bitbangbill/photoelectric-effect-demonstrator/pcb/3d/USB4110-GF-A.STEP

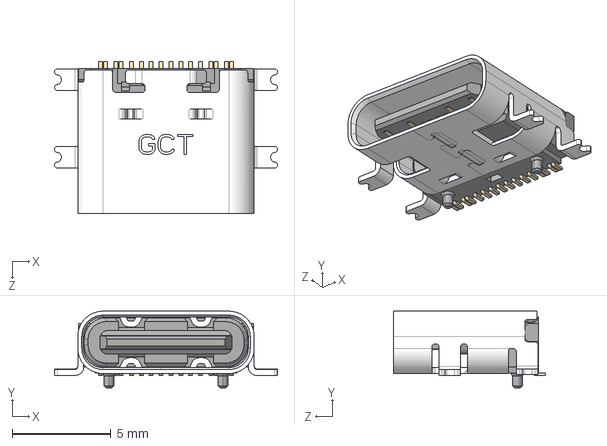
[picture p1: CAD file, 2026-09-15]
pcb/3d/USB4110-GF-A.STEP
11.3 x 3.89 x 7.70 mm
