bitbangbill/photoelectric-effect-demonstrator/pcb/3d/CCG6-12-15DR.step

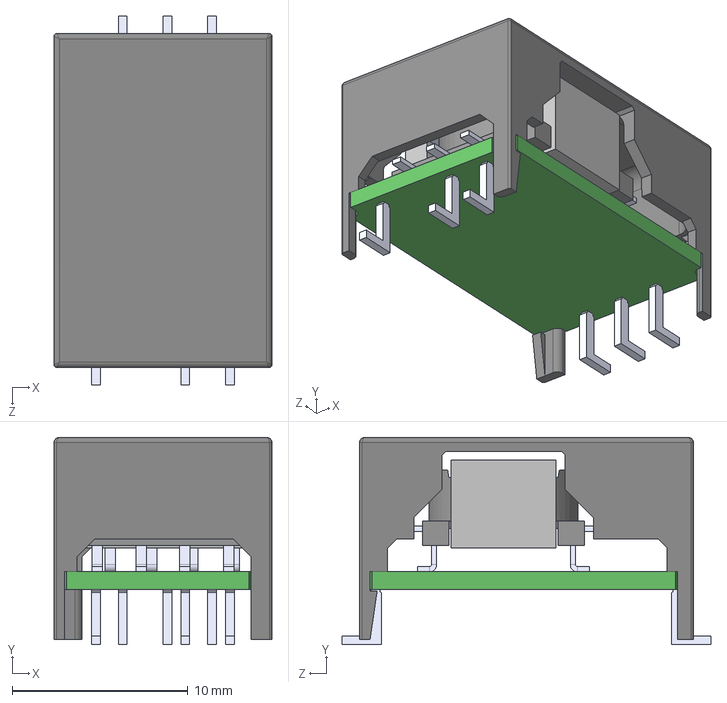
[picture p2: CAD file, 2026-09-15]
pcb/3d/CCG6-12-15DR.step
12.4 x 11.8 x 21.0 mm
