bitbangbill/photoelectric-effect-demonstrator/pcb/3d/USB4135-GF-A.step

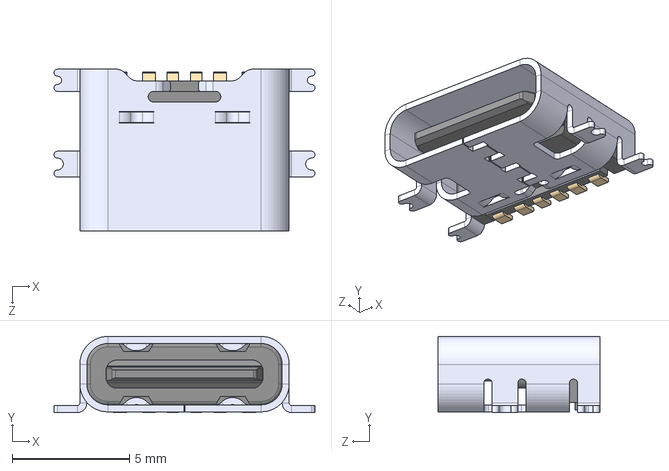
[picture p3: CAD file, 2026-09-15]
pcb/3d/USB4135-GF-A.step
11.1 x 3.25 x 6.90 mm
