bitbangbill/photoelectric-effect-demonstrator/pcb/3d/srf0905.stp

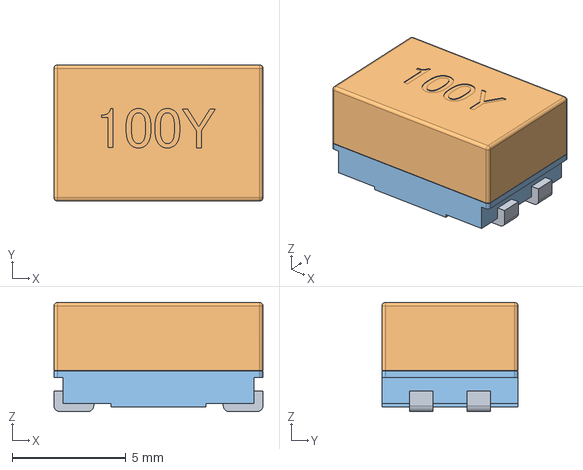
[picture p4: CAD file, 2026-09-15]
pcb/3d/srf0905.stp
9.20 x 6.00 x 4.80 mm
