bitbangbill/photoelectric-effect-demonstrator/pcb/3d/TLV75533PDBVR.STEP

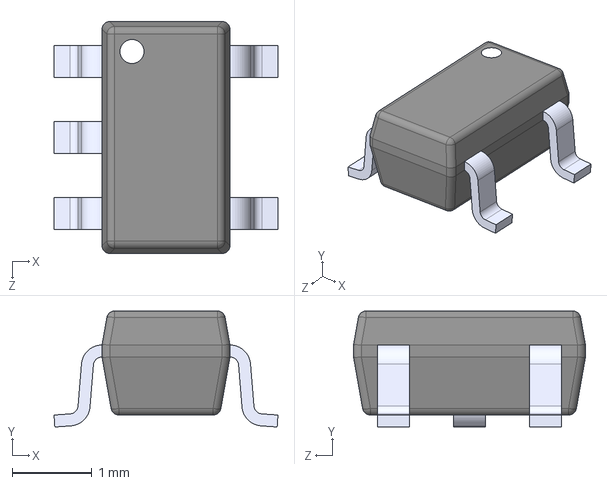
[picture p5: CAD file, 2026-09-15]
pcb/3d/TLV75533PDBVR.STEP
2.80 x 1.45 x 2.90 mm
