bitbangbill/photoelectric-effect-demonstrator/pcb/adc.kicad_sch

## KiCad design pcb/adc.kicad_sch (2026-09-15)

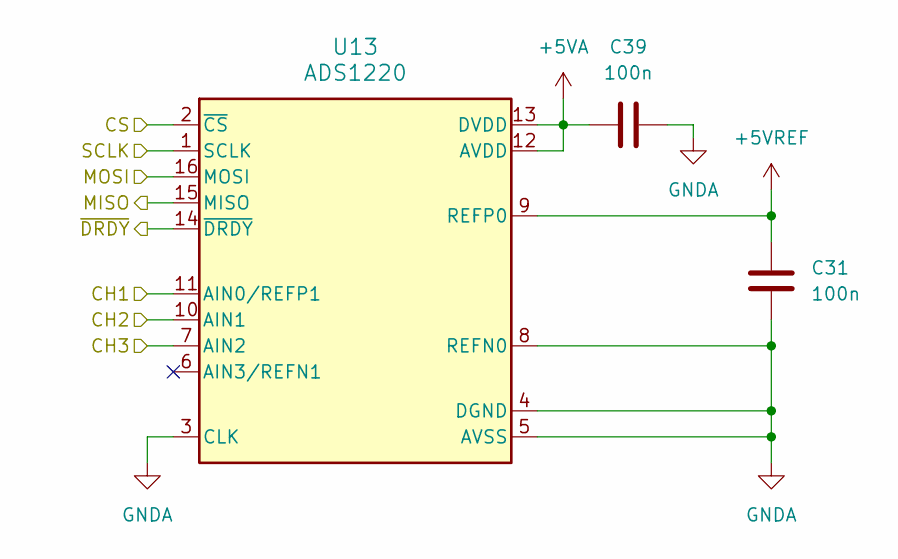
[picture p6: schematic adc.kicad_sch]

Parts:
C31, C39: 100n; C_0603_1608Metric
U13: ADS1220; TSSOP-16_4.4x5mm_P0.65mm

Connections:
+5VA: C39.1, U13.12 (AVDD), U13.13 (DVDD)
+5VREF: C31.1, U13.9 (REFP0)
CH1: U13.11 (AIN0/REFP1)
CH2: U13.10 (AIN1)
CH3: U13.7 (AIN2)
CS: U13.2 (~CS)
GNDA: C31.2, C39.2, U13.3 (CLK), U13.4 (DGND), U13.5 (AVSS), U13.8 (REFN0)
MISO: U13.15 (MISO)
MOSI: U13.16 (MOSI)
SCLK: U13.1 (SCLK)
~DRDY: U13.14 (~DRDY)
