bitbangbill/photoelectric-effect-demonstrator/pcb/digital_isolation.kicad_sch

## KiCad design pcb/digital_isolation.kicad_sch (2026-09-15)

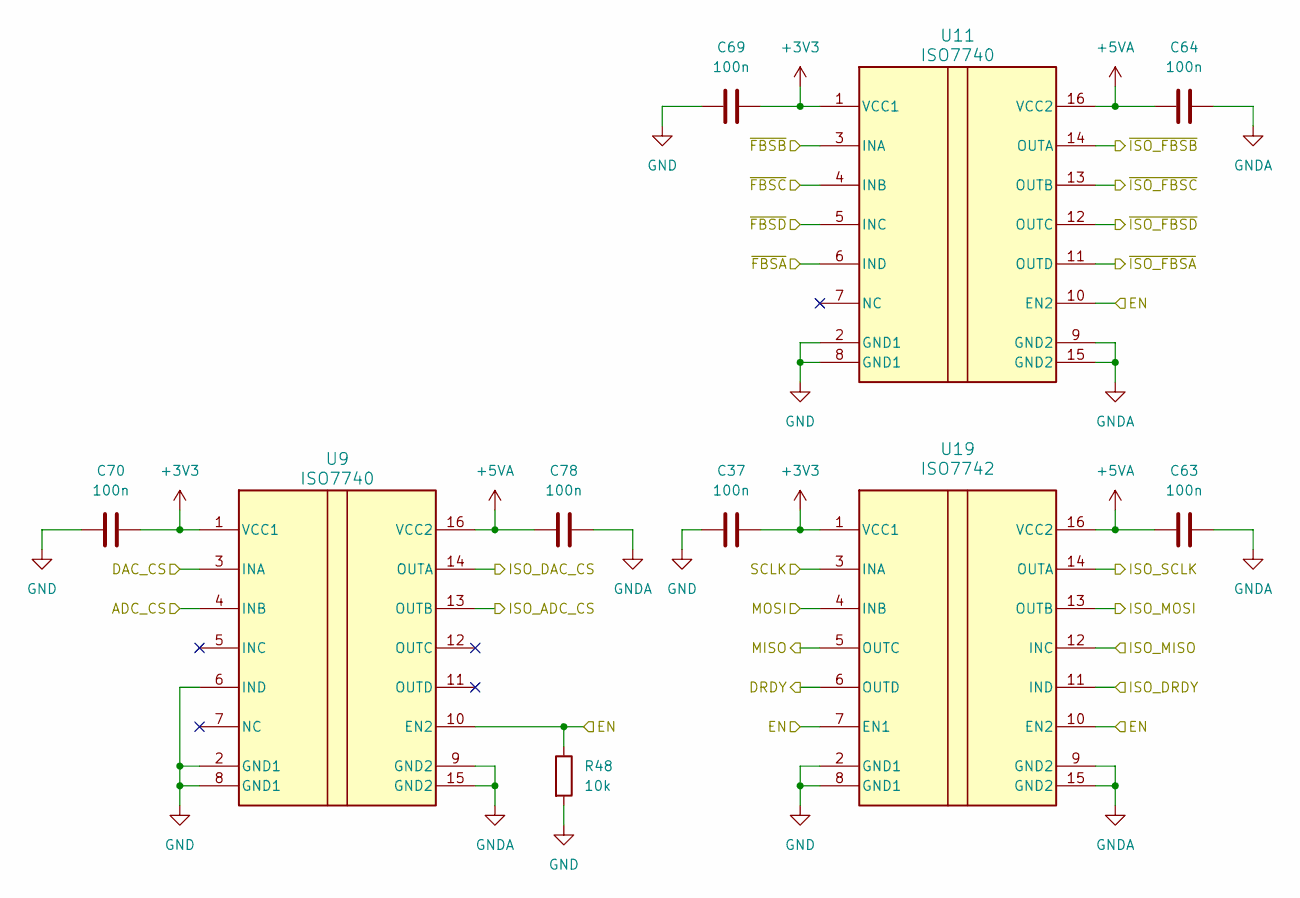
[picture p7: schematic digital_isolation.kicad_sch]

Parts:
C37, C63, C64, C69, C70, C78: 100n; C_0603_1608Metric
R48: 10k; R_0603_1608Metric
U9, U11: ISO7740; SSOP-16_3.9x4.9mm_P0.635mm
U19: ISO7742; SSOP-16_3.9x4.9mm_P0.635mm

Connections:
+3V3: C37.2, C69.2, C70.2, U9.1 (VCC1), U11.1 (VCC1), U19.1 (VCC1)
+5VA: C63.1, C64.1, C78.1, U9.16 (VCC2), U11.16 (VCC2), U19.16 (VCC2)
ADC_CS: U9.4 (INB)
DAC_CS: U9.3 (INA)
DRDY: U19.6 (OUTD)
EN: R48.1, U9.10 (EN2), U11.10 (EN2), U19.7 (EN1), U19.10 (EN2)
GND: C37.1, C69.1, C70.1, R48.2, U9.2 (GND1), U9.6 (IND), U9.8 (GND1), U11.2 (GND1), U11.8 (GND1), U19.2 (GND1), U19.8 (GND1)
GNDA: C63.2, C64.2, C78.2, U9.9 (GND2), U9.15 (GND2), U11.9 (GND2), U11.15 (GND2), U19.9 (GND2), U19.15 (GND2)
ISO_ADC_CS: U9.13 (OUTB)
ISO_DAC_CS: U9.14 (OUTA)
ISO_DRDY: U19.11 (IND)
ISO_MISO: U19.12 (INC)
ISO_MOSI: U19.13 (OUTB)
ISO_SCLK: U19.14 (OUTA)
MISO: U19.5 (OUTC)
MOSI: U19.4 (INB)
SCLK: U19.3 (INA)
~FBSA: U11.6 (IND)
~FBSB: U11.3 (INA)
~FBSC: U11.4 (INB)
~FBSD: U11.5 (INC)
~ISO_FBSA: U11.11 (OUTD)
~ISO_FBSB: U11.14 (OUTA)
~ISO_FBSC: U11.13 (OUTB)
~ISO_FBSD: U11.12 (OUTC)
