bitbangbill/photoelectric-effect-demonstrator/pcb/dual_rail_variable_psu.kicad_sch

## KiCad design pcb/dual_rail_variable_psu.kicad_sch (2026-09-15)

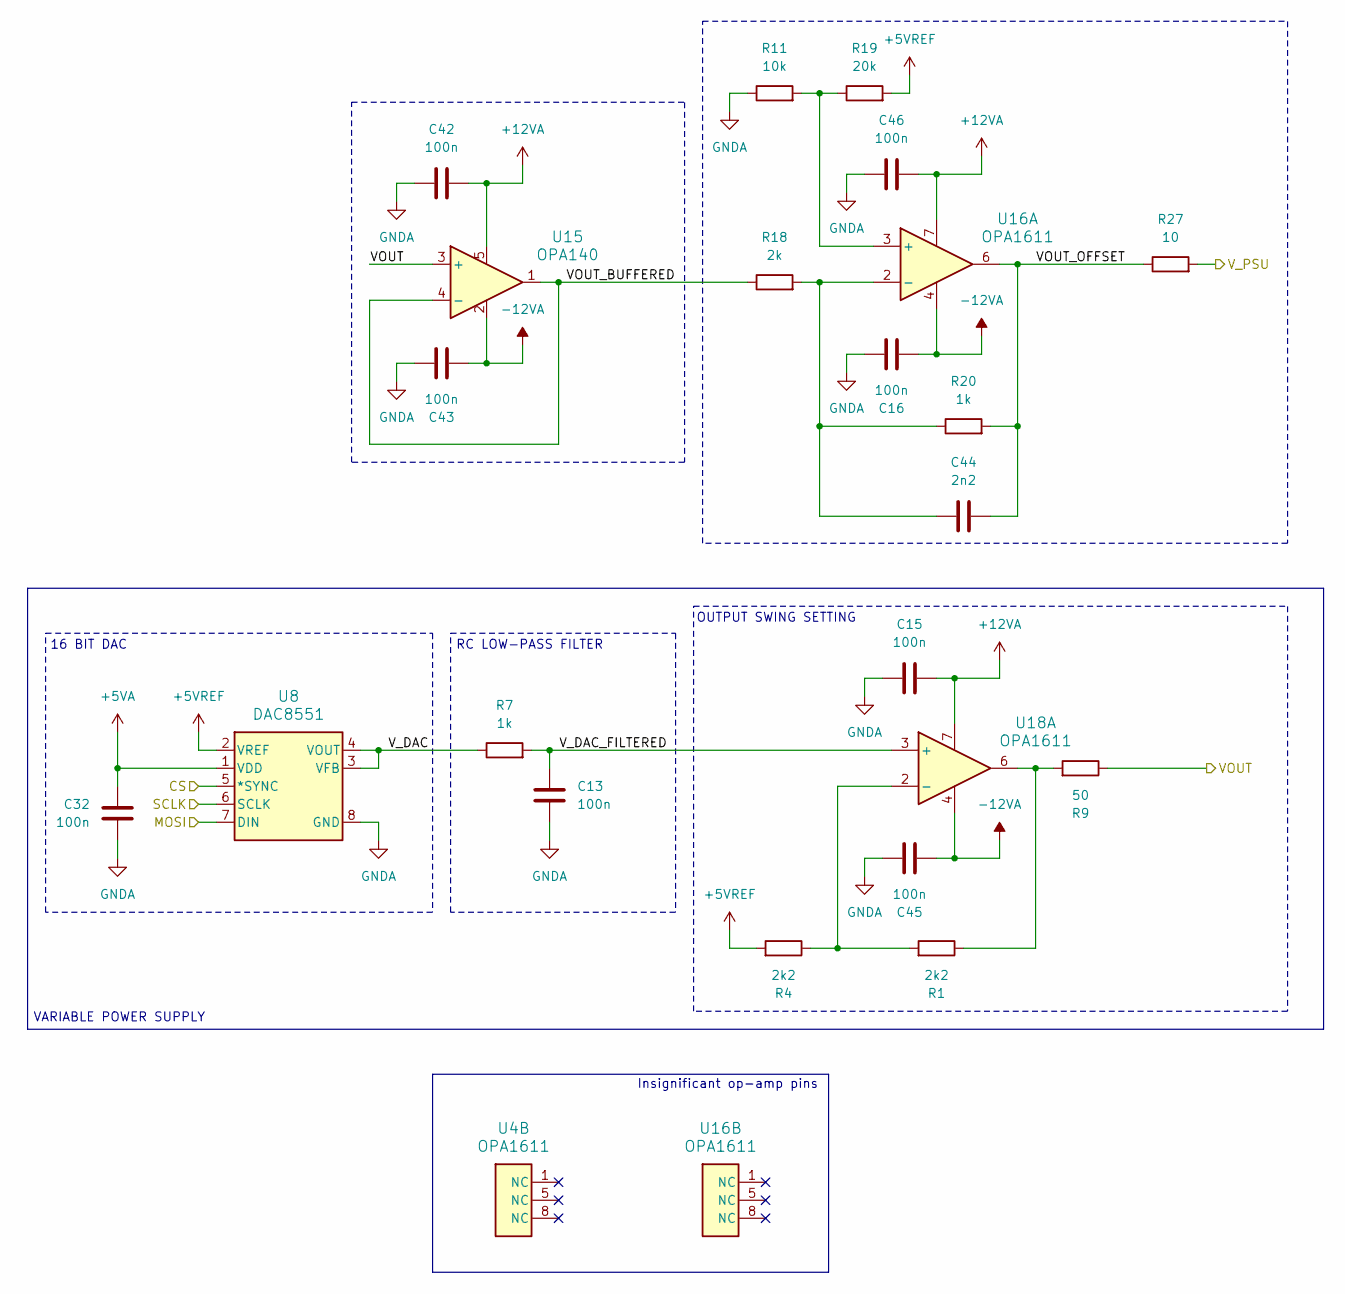
[picture p8: schematic dual_rail_variable_psu.kicad_sch]

Parts:
C13, C15, C16, C32, C42, C43, C45, C46: 100n; C_0603_1608Metric
C44: 2n2; C_0603_1608Metric
R1, R4: 2k2; R_0603_1608Metric
R7, R20: 1k; R_0603_1608Metric
R9: 50; R_0603_1608Metric
R11: 10k; R_0603_1608Metric
R18: 2k; R_0603_1608Metric
R19: 20k; R_0603_1608Metric
R27: 10; R_0603_1608Metric
U4, U16, U18: OPA1611; SOIC-8_3.9x4.9mm_P1.27mm
U8: DAC8551; VSSOP-8_3x3mm_P0.65mm
U15: OPA140; SOT-23-5

Connections:
+5VA: C32.1, U8.1 (VDD)
+5VREF: R4.2, R19.2, U8.2 (VREF)
+12VA: C15.2, C42.2, C46.2, U15.5, U16.7, U18.7
-12VA: C16.2, C43.2, C45.2, U15.2, U16.4, U18.4
CS: U8.5 (*SYNC)
GNDA: C13.2, C15.1, C16.1, C32.2, C42.1, C43.1, C45.1, C46.1, R11.1, U8.8 (GND)
MOSI: U8.7 (DIN)
unnamed: C44.1, R18.2, R20.1, U16.2 (-)
unnamed: R1.1, R9.2, U18.6
unnamed: R1.2, R4.1, U18.2 (-)
unnamed: R11.2, R19.1, U16.3 (+)
SCLK: U8.6 (SCLK)
VOUT: R9.1, U15.3 (+)
VOUT_BUFFERED: R18.1, U15.1, U15.4 (-)
VOUT_OFFSET: C44.2, R20.2, R27.1, U16.6
V_DAC: R7.1, U8.3 (VFB), U8.4 (VOUT)
V_DAC_FILTERED: C13.1, R7.2, U18.3 (+)
V_PSU: R27.2

Notes on the sheet:
RC LOW-PASS FILTER
VARIABLE POWER SUPPLY
OUTPUT SWING SETTING
16 BIT DAC
Insignificant op-amp pins
