bitbangbill/photoelectric-effect-demonstrator/pcb/encoder_layout.kicad_sch

## KiCad design pcb/encoder_layout.kicad_sch (2026-09-15)

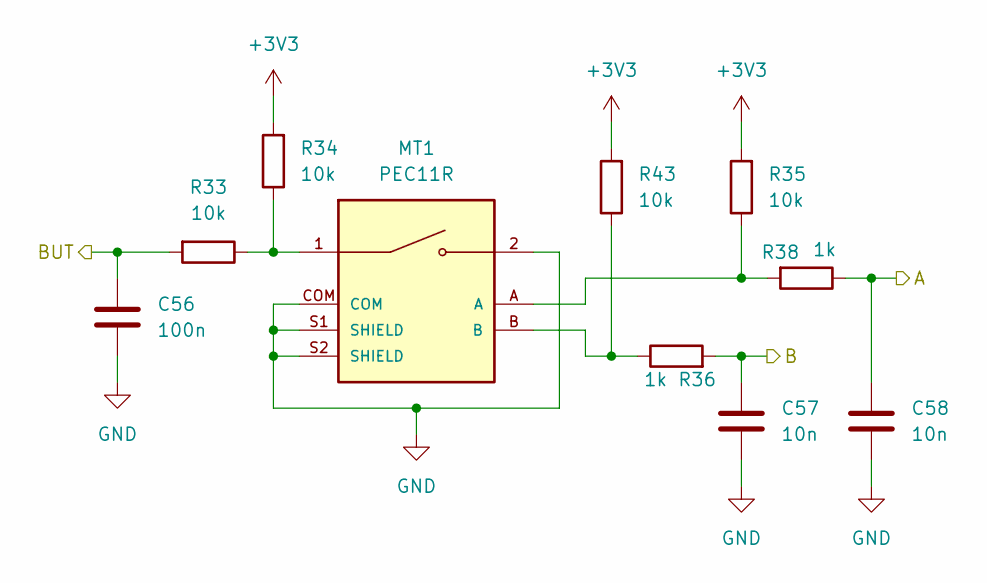
[picture p9: schematic encoder_layout.kicad_sch]

Parts:
C56: 100n; C_0603_1608Metric
C57, C58: 10n; C_0603_1608Metric
MT1: PEC11R; PARTREV Rev. 09/19
R33, R34, R35, R43: 10k; R_0603_1608Metric
R36, R38: 1k; R_0603_1608Metric

Connections:
+3V3: R34.2, R35.2, R43.2
A: C58.1, R38.1
B: C57.1, R36.2
BUT: C56.1, R33.2
GND: C56.2, C57.2, C58.2, MT1.2, MT1.COM, MT1.S1 (SHIELD), MT1.S2 (SHIELD)
unnamed: MT1.1, R33.1, R34.1
unnamed: MT1.A, R35.1, R38.2
unnamed: MT1.B, R36.1, R43.1
