bitbangbill/photoelectric-effect-demonstrator/pcb/fanout.kicad_sch

## KiCad design pcb/fanout.kicad_sch (2026-03-19)

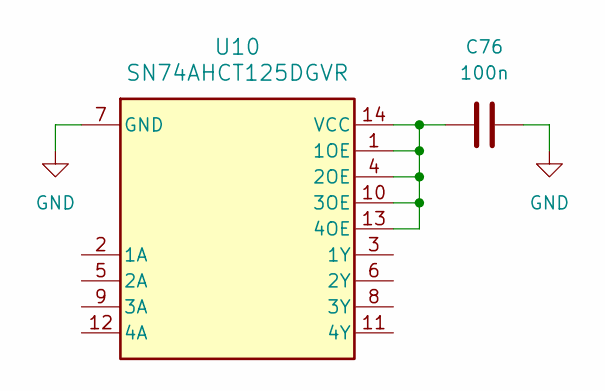
[picture p10: schematic fanout.kicad_sch]

Parts:
C76: 100n
U10: SN74AHCT125DGVR; DGV14

Connections:
GND: C76.2, U10.7 (GND)
unnamed: C76.1, U10.1 (1OE), U10.4 (2OE), U10.10 (3OE), U10.13 (4OE), U10.14 (VCC)
