bitbangbill/photoelectric-effect-demonstrator/pcb/logic_stepup.kicad_sch

## KiCad design pcb/logic_stepup.kicad_sch (2026-09-15)

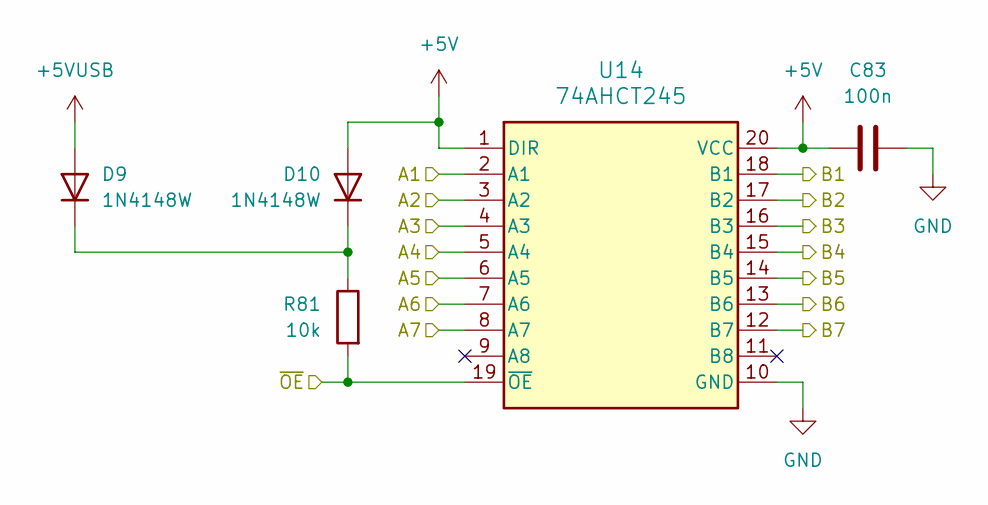
[picture p11: schematic logic_stepup.kicad_sch]

Parts:
C83: 100n; C_0603_1608Metric
D9, D10: 1N4148W; D_SOD-123
R81: 10k; R_0603_1608Metric
U14: 74AHCT245; SSOP-20_5.3x7.2mm_P0.65mm

Connections:
+5V: C83.1, D10.2 (A), U14.1 (DIR), U14.20 (VCC)
+5VUSB: D9.2 (A)
A1: U14.2 (A1)
A2: U14.3 (A2)
A3: U14.4 (A3)
A4: U14.5 (A4)
A5: U14.6 (A5)
A6: U14.7 (A6)
A7: U14.8 (A7)
B1: U14.18 (B1)
B2: U14.17 (B2)
B3: U14.16 (B3)
B4: U14.15 (B4)
B5: U14.14 (B5)
B6: U14.13 (B6)
B7: U14.12 (B7)
GND: C83.2, U14.10 (GND)
unnamed: D9.1 (K), D10.1 (K), R81.1
~OE: R81.2, U14.19 (~OE)
