bitbangbill/photoelectric-effect-demonstrator/pcb/low_noise_isloated_psu.kicad_sch

## KiCad design pcb/low_noise_isloated_psu.kicad_sch (2026-09-15)

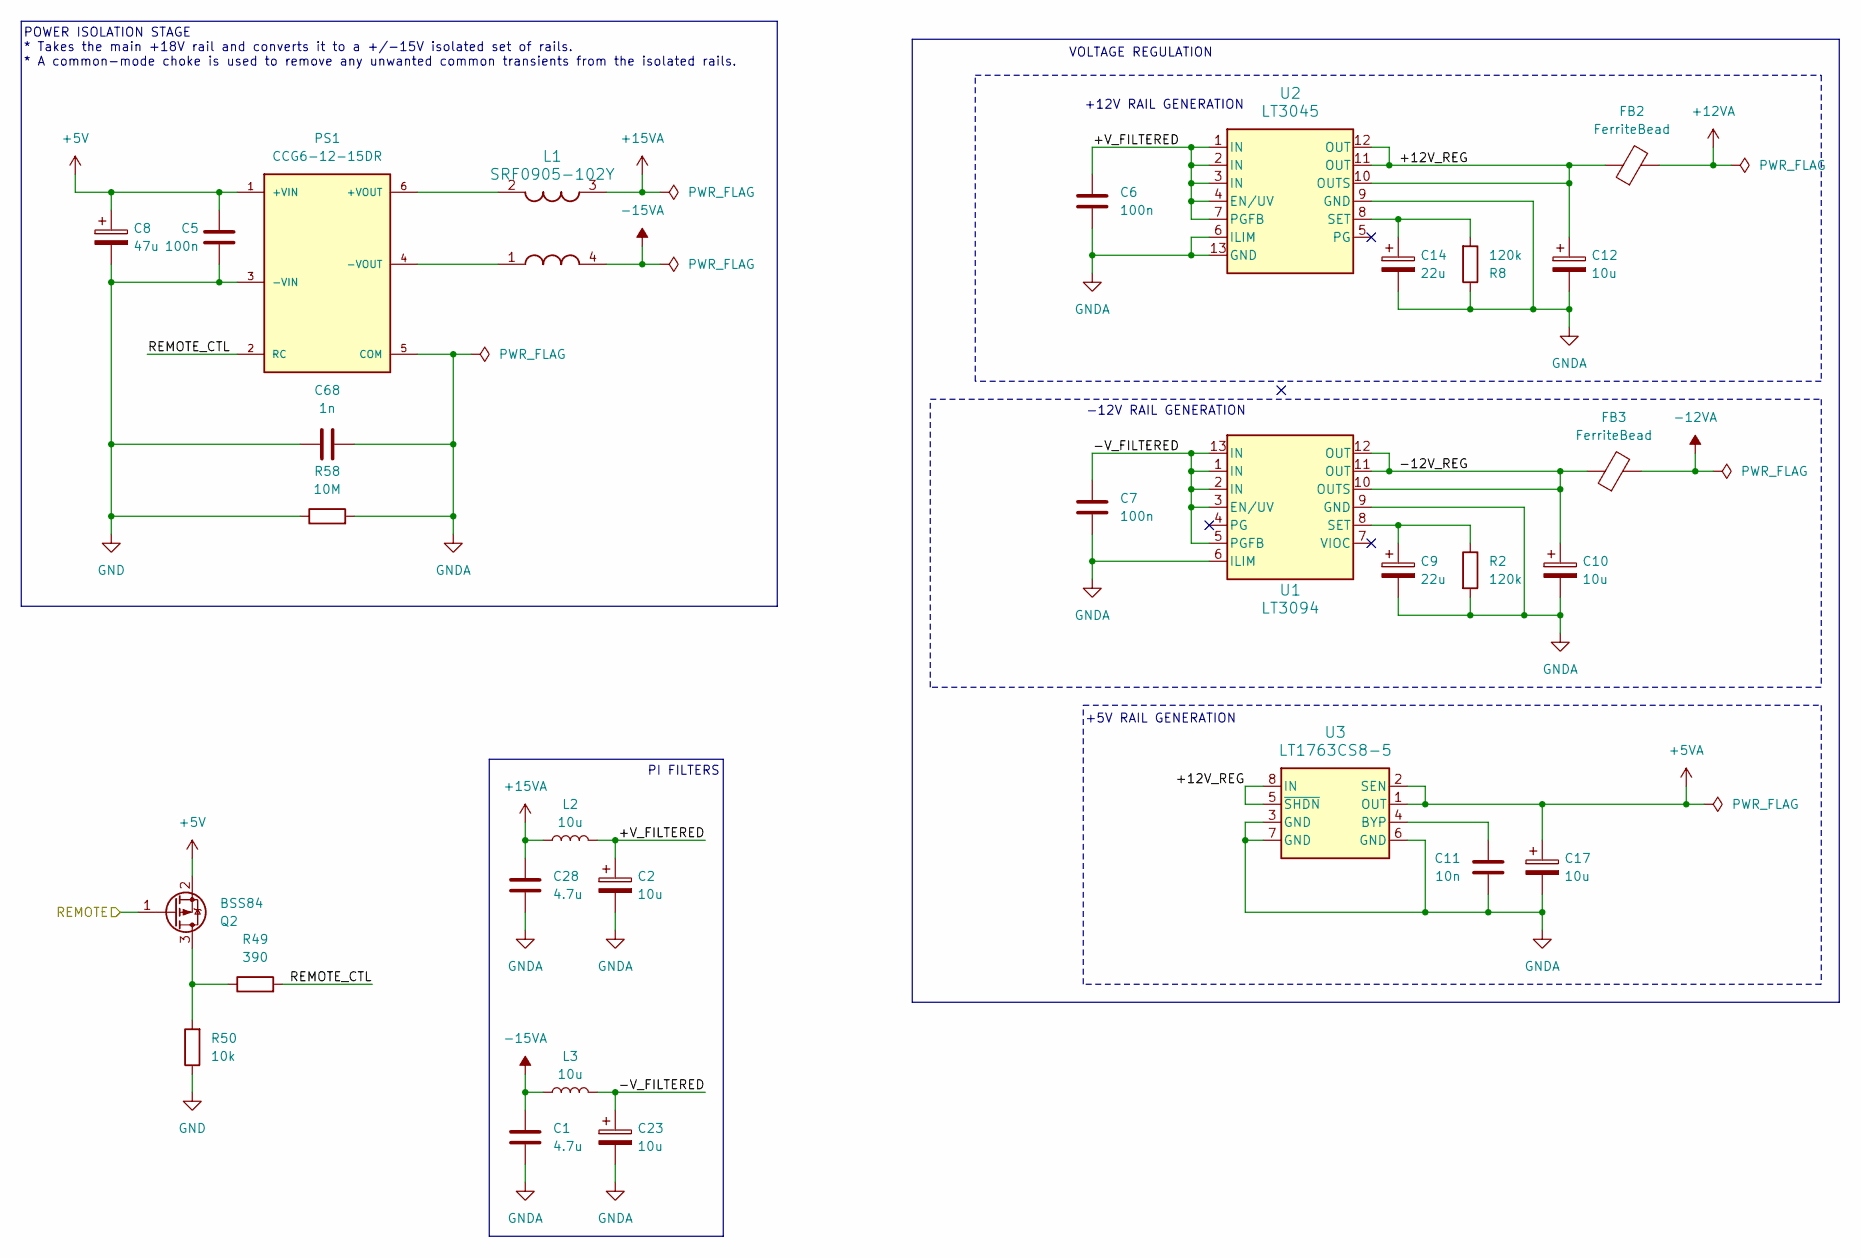
[picture p12: schematic low_noise_isloated_psu.kicad_sch]

Parts:
C1, C28: 4.7u; C_0805_2012Metric
C2, C10, C12, C17, C23: 10u; CP_EIA-3528-21_Kemet-B
C5, C6, C7: 100n; C_0603_1608Metric
C8: 47u; CP_EIA-3528-21_Kemet-B
C9, C14: 22u; CP_EIA-3528-21_Kemet-B
C11: 10n; C_0603_1608Metric
C68: 1n; C_1812_4532Metric
FB2, FB3: FerriteBead; L_0603_1608Metric
L1: SRF0905-102Y; SMT_905-102Y_BRN
L2, L3: 10u; L_6.3x6.3_H3
PS1: CCG6-12-15DR; CONV_CCG6-12-15DR; PARTREV V6
Q2: BSS84; SOT-23
R2, R8: 120k; R_0603_1608Metric
R49: 390; R_0201_0603Metric
R50: 10k; R_0201_0603Metric
R58: 10M; R_1812_4532Metric
U1: LT3094; MSOP-12-1EP_3x4.039mm_P0.65mm_EP1.651x2.845mm
U2: LT3045; MSOP-12-1EP_3x4.039mm_P0.65mm_EP1.651x2.845mm
U3: LT1763CS8-5; SOIC-8_3.9x4.9mm_P1.27mm

Connections:
+5V: C5.1, C8.1, PS1.1 (+VIN), Q2.2 (S)
+5VA: C17.1, U3.1 (OUT), U3.2 (SEN)
+12VA: FB2.2
+12V_REG: C12.1, FB2.1, U2.10 (OUTS), U2.11 (OUT), U2.12 (OUT), U3.5 (~SHDN), U3.8 (IN)
+15VA: C28.1, L1.3, L2.1
+V_FILTERED: C2.1, C6.1, L2.2, U2.1 (IN), U2.2 (IN), U2.3 (IN), U2.4 (EN/UV), U2.7 (PGFB)
-12VA: FB3.2
-12V_REG: C10.1, FB3.1, U1.10 (OUTS), U1.11 (OUT), U1.12 (OUT)
-15VA: C1.1, L1.4, L3.1
-V_FILTERED: C7.1, C23.1, L3.2, U1.1 (IN), U1.2 (IN), U1.3 (EN/UV), U1.5 (PGFB), U1.13 (IN)
GND: C5.2, C8.2, C68.1, PS1.3 (-VIN), R50.1, R58.1
GNDA: C1.2, C2.2, C6.2, C7.2, C9.2, C10.2, C11.2, C12.2, C14.2, C17.2, C23.2, C28.2, C68.2, PS1.5 (COM), R2.2, R8.1, R58.2, U1.6 (ILIM), U1.9 (GND), U2.6 (ILIM), U2.9 (GND), U2.13 (GND), U3.3 (GND), U3.6 (GND), U3.7 (GND)
unnamed: C9.1, R2.1, U1.8 (SET)
unnamed: C11.1, U3.4 (BYP)
unnamed: C14.1, R8.2, U2.8 (SET)
unnamed: L1.1, PS1.4 (-VOUT)
unnamed: L1.2, PS1.6 (+VOUT)
unnamed: Q2.3 (D), R49.1, R50.2
REMOTE: Q2.1 (G)
REMOTE_CTL: PS1.2 (RC), R49.2

Notes on the sheet:
+5V RAIL GENERATION
-12V RAIL GENERATION
POWER ISOLATION STAGE * Takes the main +18V rail and converts it to a +/-15V isolated set of rails. * A common-mode choke is used to remove any unwanted common transients from the isolated rails.
VOLTAGE REGULATION
+12V RAIL GENERATION
PI FILTERS
