bitbangbill/photoelectric-effect-demonstrator/pcb/microcontroller.kicad_sch

## KiCad design pcb/microcontroller.kicad_sch (2026-09-15)

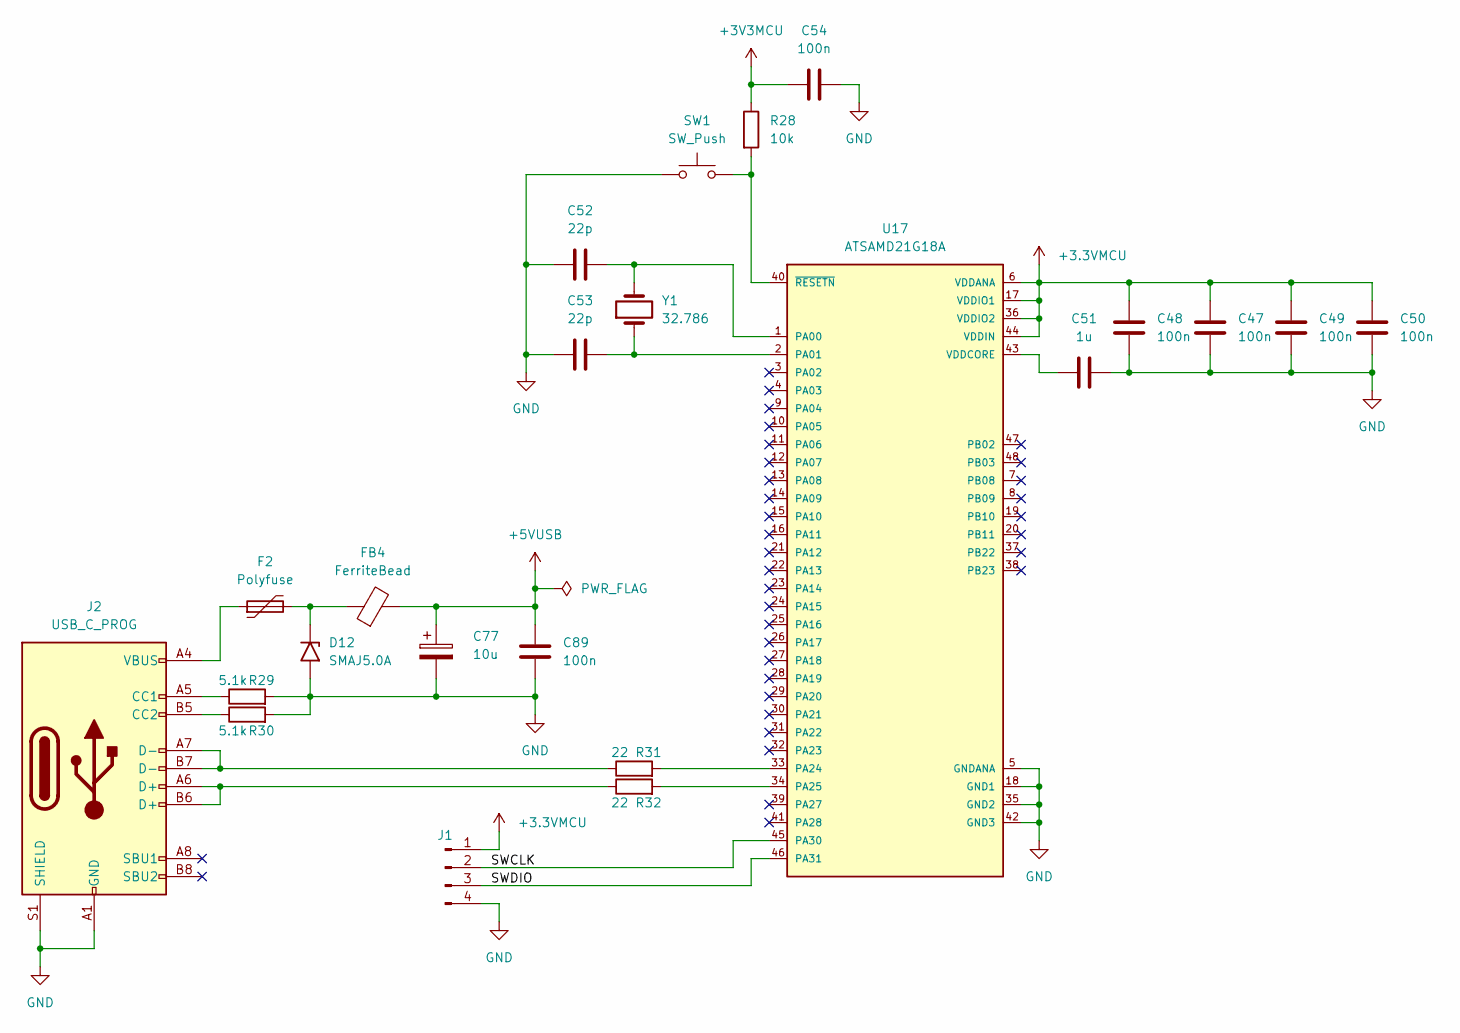
[picture p13: schematic microcontroller.kicad_sch]

Parts:
C47, C48, C49, C50, C54, C89: 100n; C_0603_1608Metric
C51: 1u; C_0603_1608Metric
C52, C53: 22p; C_0603_1608Metric
C77: 10u; CP_EIA-3528-12_Kemet-T
D12: SMAJ5.0A; D_SMA
F2: Polyfuse; Fuse_1812_4532Metric
FB4: FerriteBead; L_0603_1608Metric
J1: Conn_01x04_Pin; FanPinHeader_1x04_P2.54mm_Vertical
J2: USB_C_PROG; USB4110-GF-A
R28: 10k; R_0603_1608Metric
R29, R30: 5.1k; R_0603_1608Metric
R31, R32: 22; R_0603_1608Metric
SW1: SW_Push; SWT0310-043016GSA
U17: ATSAMD21G18A; TQFP-48_7x7mm_P0.5mm
Y1: 32.786; Crystal_AT310_D3.0mm_L10.0mm_Horizontal

Connections:
+3.3VMCU: C47.1, C48.1, C49.1, C50.1, J1.1, U17.6 (VDDANA), U17.17 (VDDIO1), U17.36 (VDDIO2), U17.44 (VDDIN)
+3V3MCU: C54.1, R28.1
+5VUSB: C77.1, C89.2, FB4.2
GND: C47.2, C48.2, C49.2, C50.2, C51.2, C52.1, C53.1, C54.2, C77.2, C89.1, D12.2 (A2), J1.4, J2.A1 (GND), J2.A12 (GND), J2.B1 (GND), J2.B12 (GND), J2.S1 (SHIELD), R29.2, R30.2, SW1.1, U17.5 (GNDANA), U17.18 (GND1), U17.35 (GND2), U17.42 (GND3)
unnamed: C51.1, U17.43 (VDDCORE)
unnamed: C52.2, U17.1 (PA00), Y1.2
unnamed: C53.2, U17.2 (PA01), Y1.1
unnamed: D12.1 (A1), F2.2, FB4.1
unnamed: F2.1, J2.A4 (VBUS), J2.A9 (VBUS), J2.B4 (VBUS), J2.B9 (VBUS)
unnamed: J2.A5 (CC1), R29.1
unnamed: J2.A6 (D+), J2.B6 (D+), R32.1
unnamed: J2.A7 (D-), J2.B7 (D-), R31.1
unnamed: J2.B5 (CC2), R30.1
unnamed: R28.2, SW1.2, U17.40 (~RESETN)
unnamed: R31.2, U17.33 (PA24)
unnamed: R32.2, U17.34 (PA25)
SWCLK: J1.2, U17.45 (PA30)
SWDIO: J1.3, U17.46 (PA31)
