bitbangbill/photoelectric-effect-demonstrator/pcb/phototube_instrumentation.kicad_sch

## KiCad design pcb/phototube_instrumentation.kicad_sch (2026-09-15)

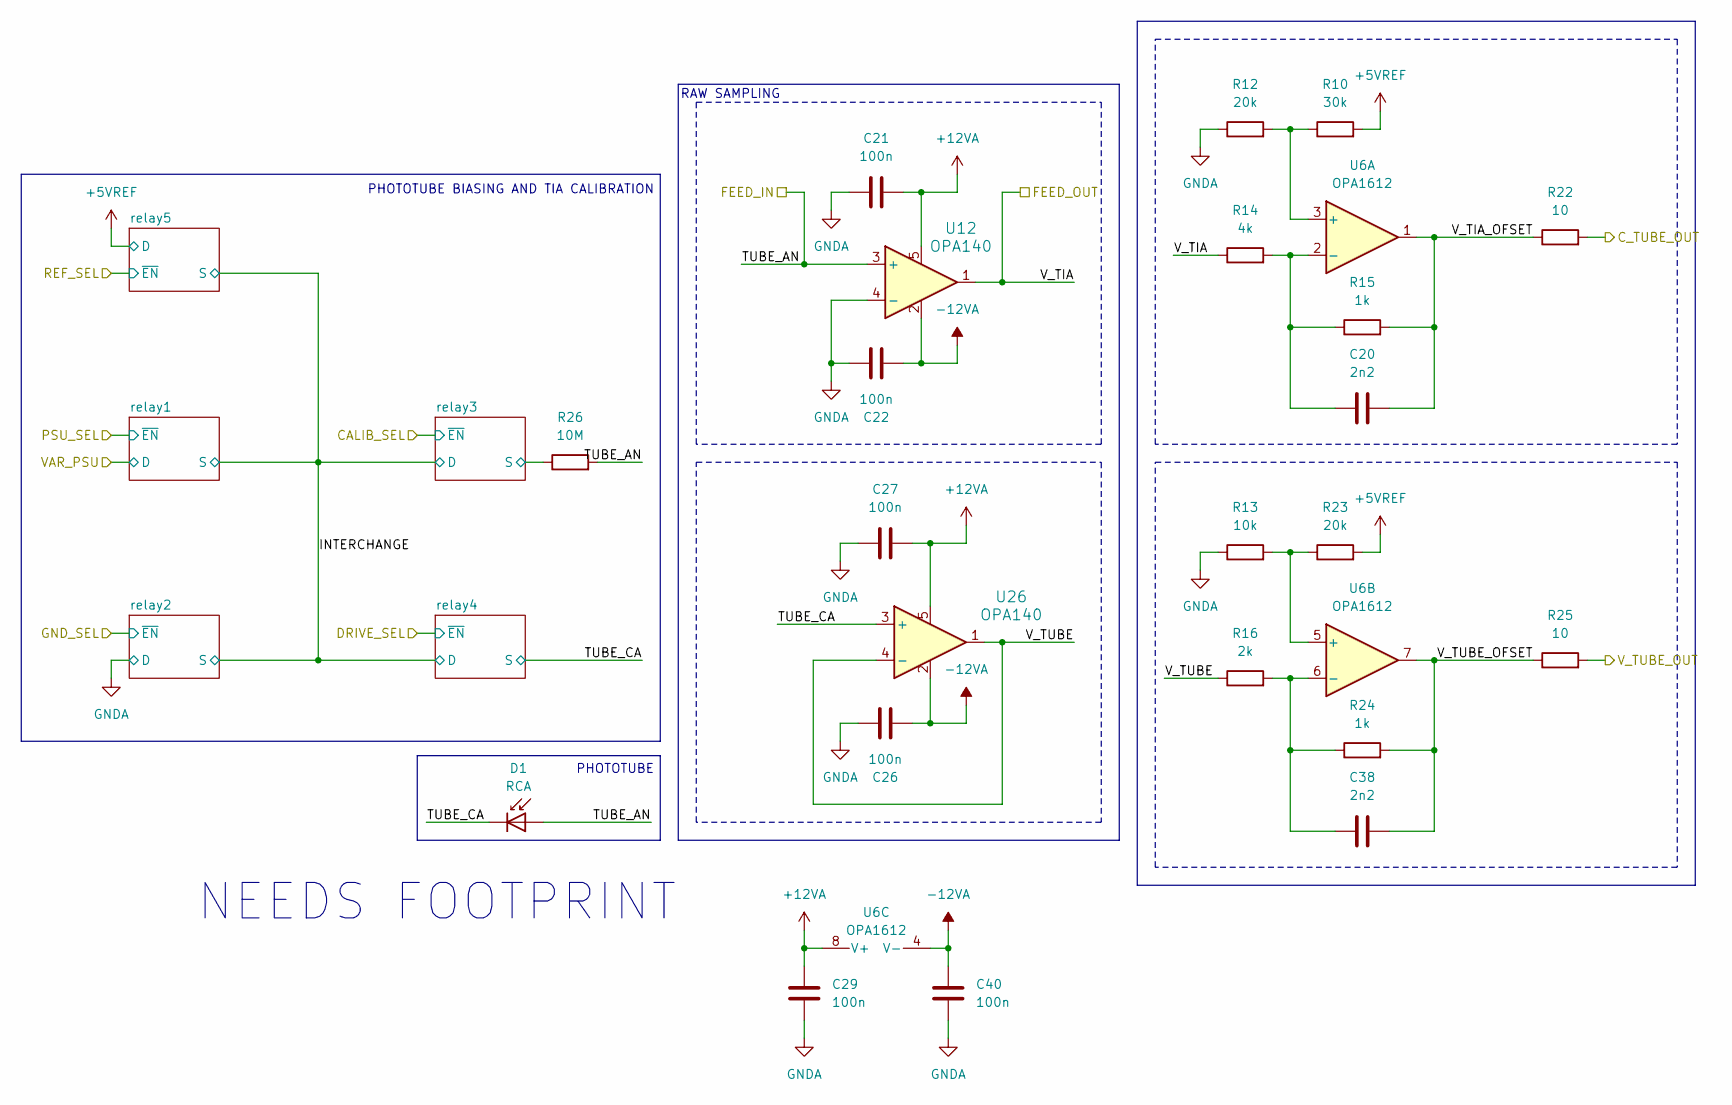
[picture p14: schematic phototube_instrumentation.kicad_sch]

Parts:
C20, C38: 2n2; C_0603_1608Metric
C21, C22, C26, C27, C29, C40: 100n; C_0603_1608Metric
D1: RCA
R10: 30k; R_0603_1608Metric
R12, R23: 20k; R_0603_1608Metric
R13: 10k; R_0603_1608Metric
R14: 4k; R_0603_1608Metric
R15, R24: 1k; R_0603_1608Metric
R16: 2k; R_0603_1608Metric
R22, R25: 10; R_0603_1608Metric
R26: 10M; R_0603_1608Metric
U6: OPA1612; SOIC-8_3.9x4.9mm_P1.27mm
U12, U26: OPA140; SOT-23-5

Connections:
+5VREF: R10.2, R23.2
+12VA: C21.2, C27.2, C29.1, U6.8 (V+), U12.5, U26.5
-12VA: C22.2, C26.2, C40.1, U6.4 (V-), U12.2, U26.2
C_TUBE_OUT: R22.2
FEED_IN: D1.2 (A), R26.2, U12.3 (+)
FEED_OUT: R14.1, U12.1
GNDA: C21.1, C22.1, C26.1, C27.1, C29.2, C40.2, R12.1, R13.1, U12.4 (-)
unnamed: C20.1, R14.2, R15.1, U6.2 (-)
unnamed: C38.1, R16.2, R24.1, U6.6 (-)
unnamed: R10.1, R12.2, U6.3 (+)
unnamed: R13.2, R23.1, U6.5 (+)
S: R26.1
TUBE_CA: D1.1 (K), U26.3 (+)
V_TIA_OFSET: C20.2, R15.2, R22.1, U6.1
V_TUBE: R16.1, U26.1, U26.4 (-)
V_TUBE_OFSET: C38.2, R24.2, R25.1, U6.7
V_TUBE_OUT: R25.2

Notes on the sheet:
RAW SAMPLING
PHOTOTUBE BIASING AND TIA CALIBRATION
NEEDS FOOTPRINT
PHOTOTUBE
