bitbangbill/photoelectric-effect-demonstrator/pcb/reference_voltage.kicad_sch

## KiCad design pcb/reference_voltage.kicad_sch (2026-09-15)

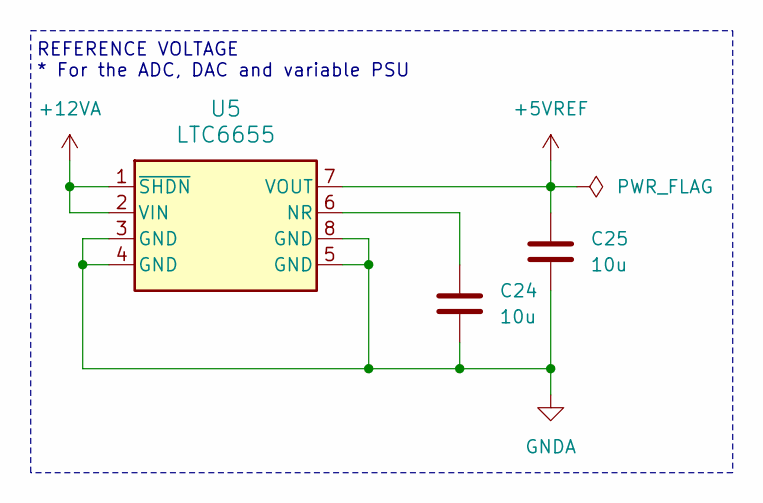
[picture p15: schematic reference_voltage.kicad_sch]

Parts:
C24, C25: 10u; C_0201_0603Metric
U5: LTC6655; MSOP-8_3x3mm_P0.65mm

Connections:
+5VREF: C25.1, U5.7 (VOUT)
+12VA: U5.1 (~SHDN), U5.2 (VIN)
GNDA: C24.2, C25.2, U5.3 (GND), U5.4 (GND), U5.5 (GND), U5.8 (GND)
unnamed: C24.1, U5.6 (NR)

Notes on the sheet:
REFERENCE VOLTAGE * For the ADC, DAC and variable PSU
