bitbangbill/photoelectric-effect-demonstrator/pcb/relay.kicad_sch

## KiCad design pcb/relay.kicad_sch (2026-09-15)

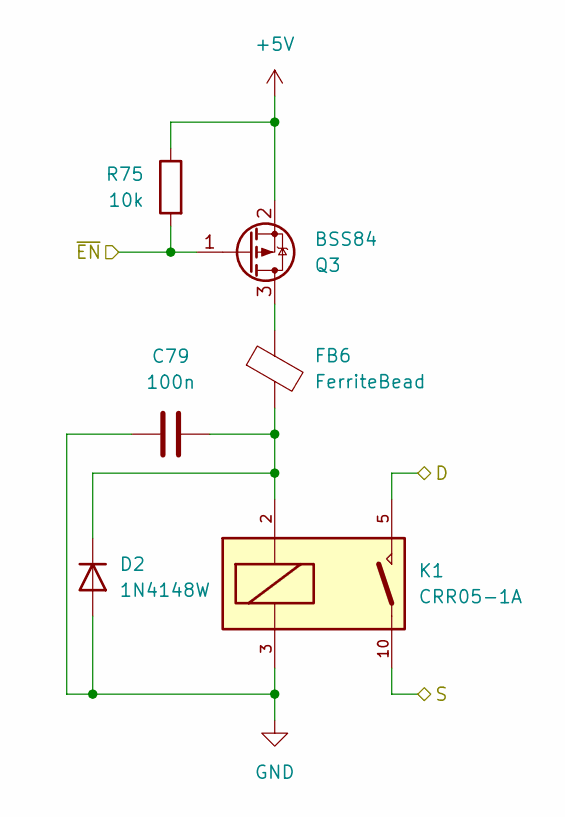
[picture p16: schematic relay.kicad_sch]

Parts:
C79: 100n; C_0603_1608Metric
D2: 1N4148W; D_SOD-123
FB6: FerriteBead; L_0603_1608Metric
K1: CRR05-1A
Q3: BSS84; SOT-23
R75: 10k; R_0603_1608Metric

Connections:
+5V: Q3.2 (S), R75.1
D: K1.5
GND: C79.2, D2.2 (A), K1.3
unnamed: C79.1, D2.1 (K), FB6.2, K1.2
unnamed: FB6.1, Q3.3 (D)
S: K1.10
~EN: Q3.1 (G), R75.2
