bitbangbill/photoelectric-effect-demonstrator/pcb/tia_feedback_select.kicad_sch

## KiCad design pcb/tia_feedback_select.kicad_sch (2026-09-15)

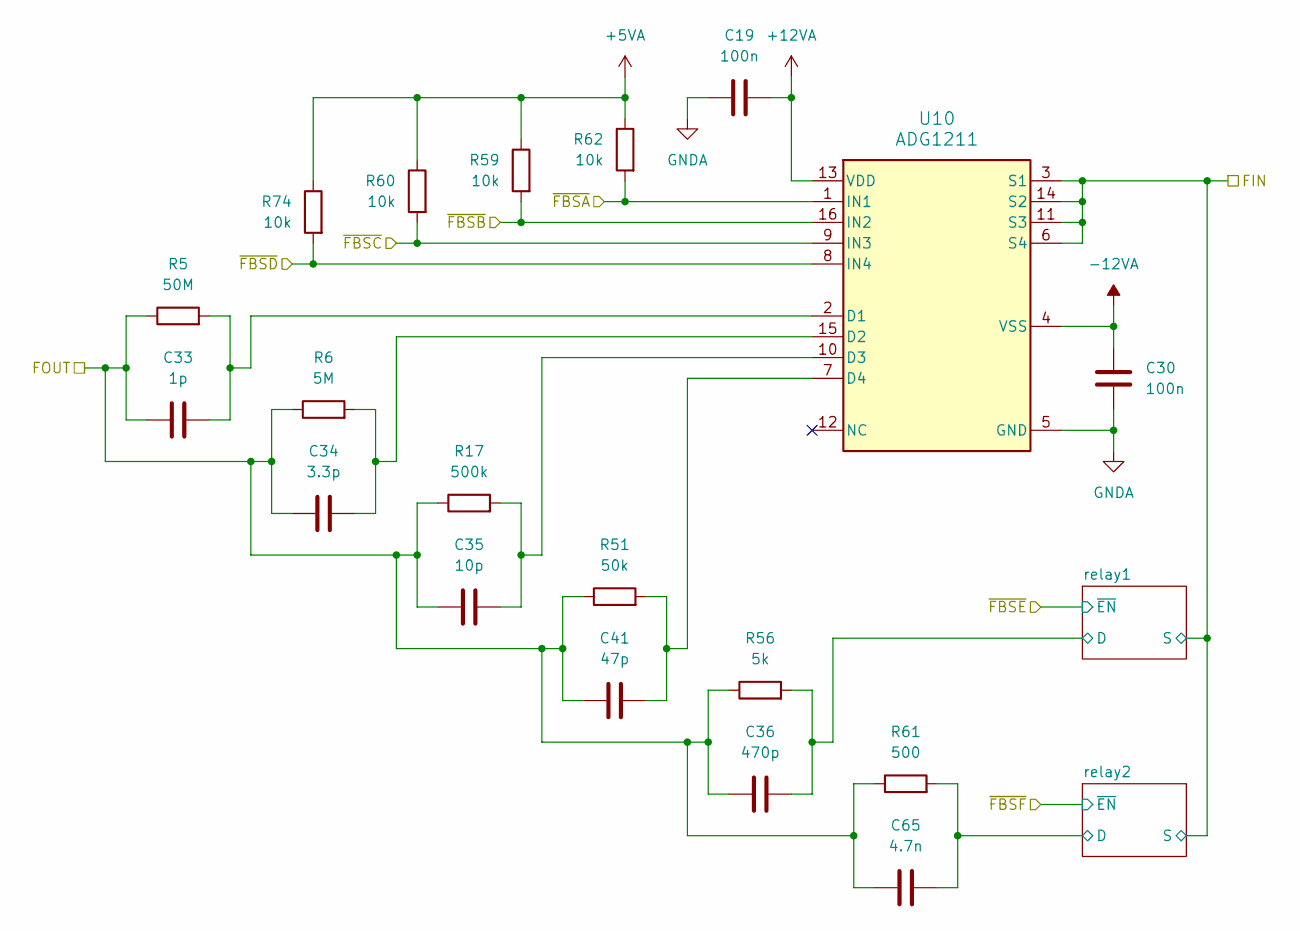
[picture p17: schematic tia_feedback_select.kicad_sch]

Parts:
C19, C30: 100n; C_0603_1608Metric
C33: 1p; C_0603_1608Metric
C34: 3.3p; C_0603_1608Metric
C35: 10p; C_0603_1608Metric
C36: 470p; C_0603_1608Metric
C41: 47p; C_0603_1608Metric
C65: 4.7n; C_0603_1608Metric
R5: 50M; R_0603_1608Metric
R6: 5M; R_0603_1608Metric
R17: 500k; R_0603_1608Metric
R51: 50k; R_0603_1608Metric
R56: 5k; R_0603_1608Metric
R59, R60, R62, R74: 10k; R_0603_1608Metric
R61: 500; R_0603_1608Metric
U10: ADG1211; TSSOP-16_4.4x5mm_P0.65mm

Connections:
+5VA: R59.1, R60.1, R62.1, R74.1
+12VA: C19.1, U10.13 (VDD)
-12VA: C30.1, U10.4 (VSS)
D: C36.2, C65.2, R56.2, R61.2
FIN: U10.3 (S1), U10.6 (S4), U10.11 (S3), U10.14 (S2)
FOUT: C33.1, C34.1, C35.1, C36.1, C41.1, C65.1, R5.1, R6.1, R17.1, R51.1, R56.1, R61.1
GNDA: C19.2, C30.2, U10.5 (GND)
unnamed: C33.2, R5.2, U10.2 (D1)
unnamed: C34.2, R6.2, U10.15 (D2)
unnamed: C35.2, R17.2, U10.10 (D3)
unnamed: C41.2, R51.2, U10.7 (D4)
~FBSA: R62.2, U10.1 (IN1)
~FBSB: R59.2, U10.16 (IN2)
~FBSC: R60.2, U10.9 (IN3)
~FBSD: R74.2, U10.8 (IN4)
