bitbangbill/photoelectric-effect-demonstrator/pcb/ui.kicad_sch

## KiCad design pcb/ui.kicad_sch (2026-09-15)

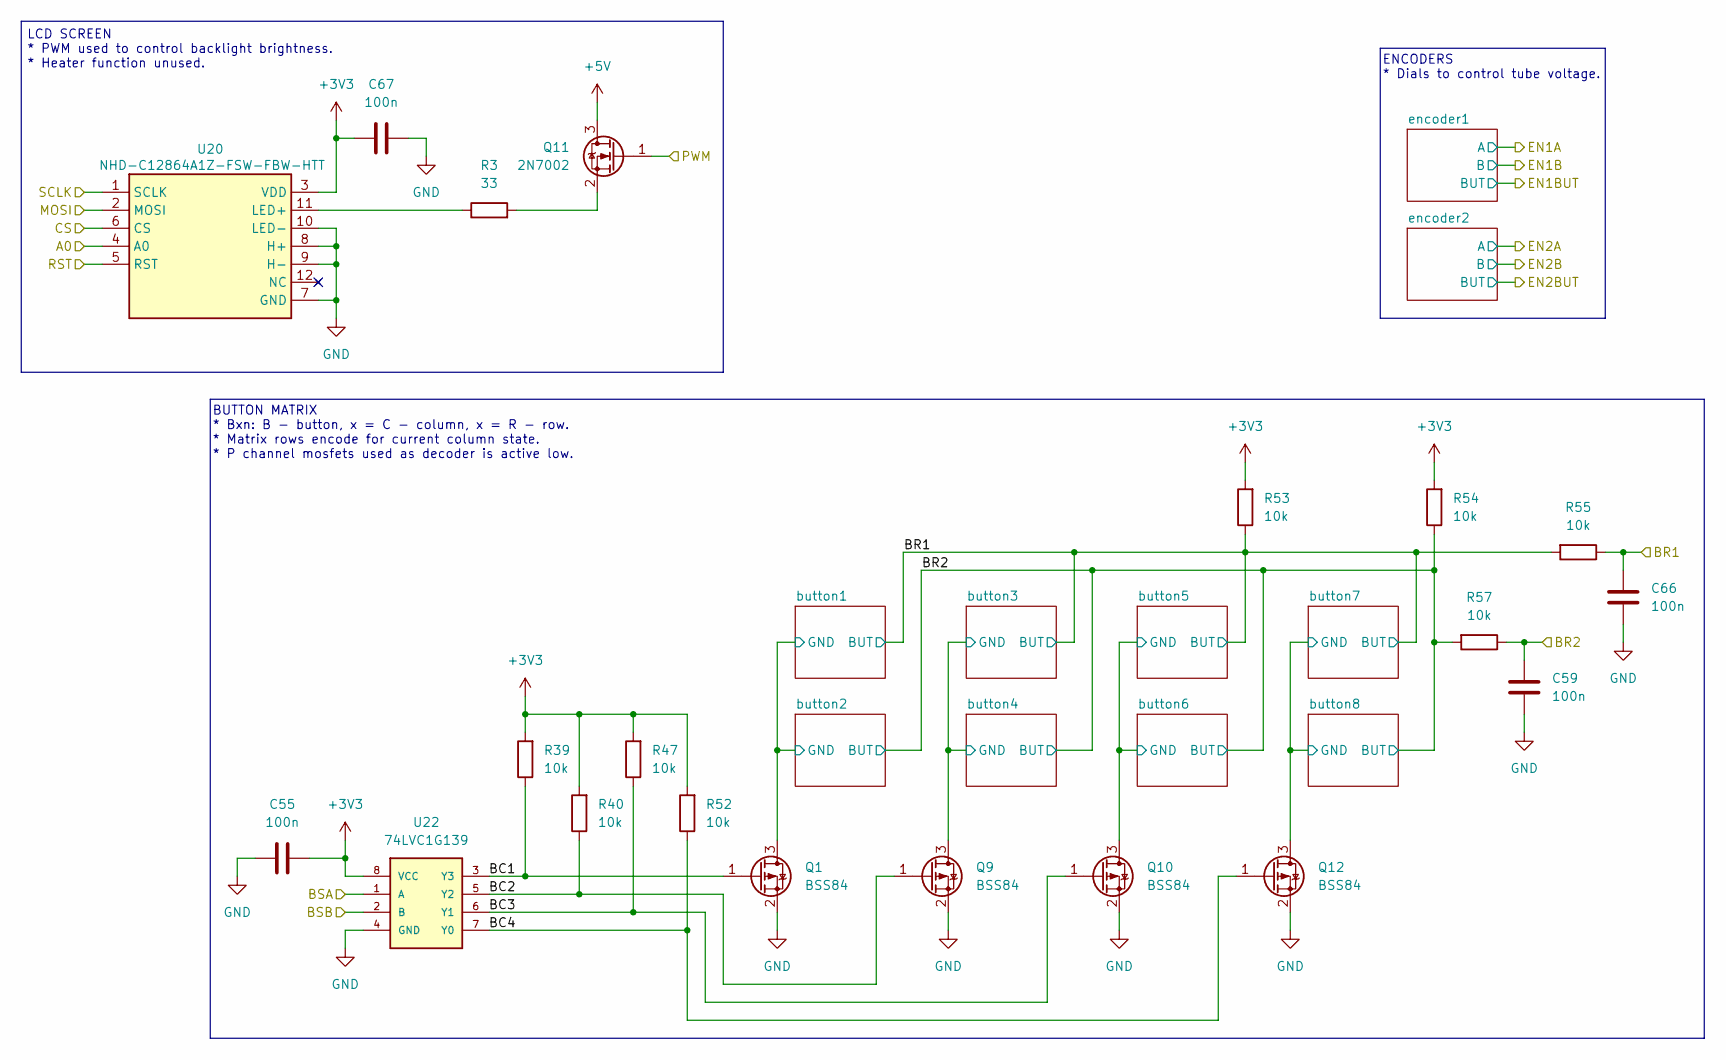
[picture p18: schematic ui.kicad_sch]

Parts:
C55, C67: 100n; C_0603_1608Metric
C59, C66: 100n; C_0201_0603Metric
Q1, Q9, Q10, Q12: BSS84; SOT-23
Q11: 2N7002; SOT-23
R3: 33; R_0603_1608Metric
R39, R40, R47, R52, R53, R54, R55, R57: 10k; R_0603_1608Metric
U20: NHD-C12864A1Z-FSW-FBW-HTT
U22: 74LVC1G139; VSSOP-8_2.3x2mm_P0.5mm; PARTREV E

Connections:
+3V3: C55.2, C67.1, R39.2, R40.2, R47.2, R52.2, R53.2, R54.2, U20.3 (VDD), U22.8 (VCC)
+5V: Q11.3 (D)
A0: U20.4 (A0)
BC1: Q1.1 (G), R39.1, U22.3 (Y3)
BC2: Q9.1 (G), R40.1, U22.5 (Y2)
BC3: Q10.1 (G), R47.1, U22.6 (Y1)
BC4: Q12.1 (G), R52.1, U22.7 (Y0)
BR1: C66.2, R53.1, R55.1, R55.2
BR2: C59.2, R54.1, R57.1, R57.2
BSA: U22.1 (A)
BSB: U22.2 (B)
CS: U20.6 (CS)
GND: C55.1, C59.1, C66.1, C67.2, Q1.2 (S), Q1.3 (D), Q9.2 (S), Q9.3 (D), Q10.2 (S), Q10.3 (D), Q12.2 (S), Q12.3 (D), U20.7 (GND), U20.8 (H+), U20.9 (H-), U20.10 (LED-), U22.4 (GND)
MOSI: U20.2 (MOSI)
unnamed: Q11.2 (S), R3.2
unnamed: R3.1, U20.11 (LED+)
PWM: Q11.1 (G)
RST: U20.5 (RST)
SCLK: U20.1 (SCLK)

Notes on the sheet:
BUTTON MATRIX * Bxn: B - button, x = C - column, x = R - row. * Matrix rows encode for current column state. * P channel mosfets used as decoder is active low.
LCD SCREEN * PWM used to control backlight brightness. * Heater function unused.
ENCODERS * Dials to control tube voltage.
