bitbangbill/photoelectric-effect-demonstrator/pcb/usbc_psu.kicad_sch

## KiCad design pcb/usbc_psu.kicad_sch (2026-09-15)

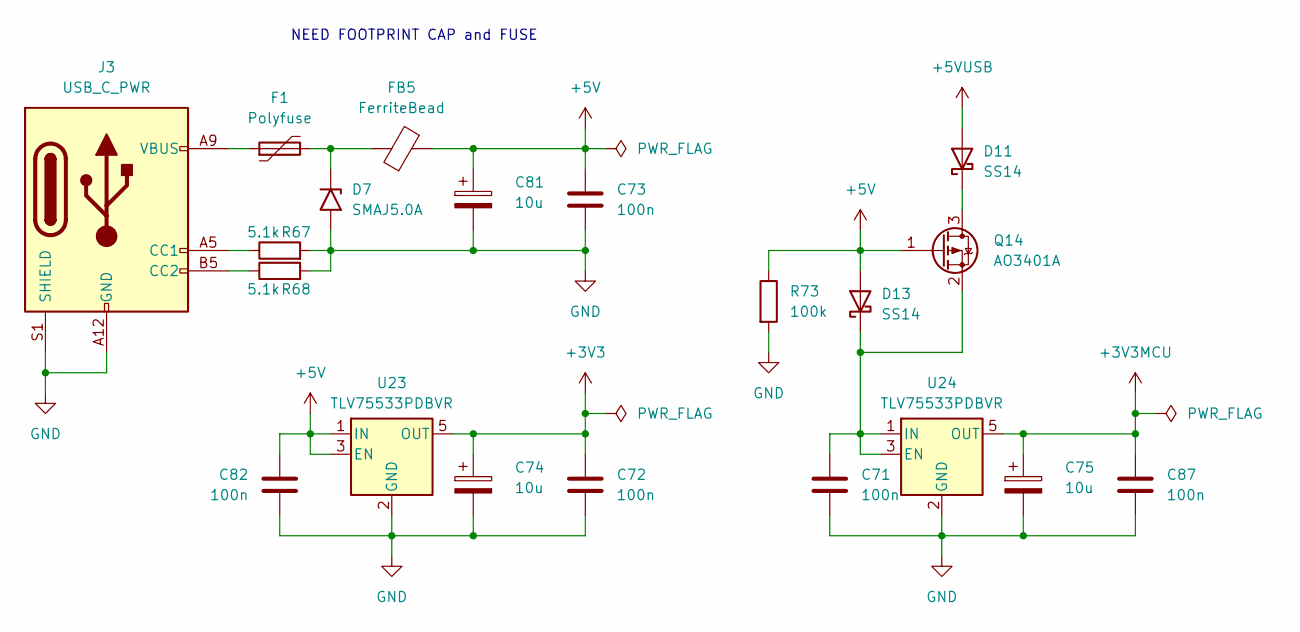
[picture p19: schematic usbc_psu.kicad_sch]

Parts:
C71, C72, C73, C87: 100n; C_0603_1608Metric
C74, C75, C81: 10u; CP_EIA-3528-12_Kemet-T
C82: 100n; C_0201_0603Metric
D7: SMAJ5.0A; D_SMA
D11, D13: SS14; D_SMA
F1: Polyfuse; Fuse_1812_4532Metric
FB5: FerriteBead; L_0603_1608Metric
J3: USB_C_PWR; USB4135-GF-A
Q14: AO3401A; SOT-23
R67, R68: 5.1k; R_0603_1608Metric
R73: 100k; R_0603_1608Metric
U23, U24: TLV75533PDBVR; SOT95P280X145-5N

Connections:
+3V3: C72.2, C74.1, U23.5 (OUT)
+3V3MCU: C75.1, C87.2, U24.5 (OUT)
+5V: C73.2, C81.1, C82.1, D13.2 (A), FB5.2, Q14.1 (G), R73.1, U23.1 (IN), U23.3 (EN)
+5VUSB: D11.2 (A)
GND: C71.1, C72.1, C73.1, C74.2, C75.2, C81.2, C82.2, C87.1, D7.2 (A2), J3.A12 (GND), J3.B12 (GND), J3.S1 (SHIELD), J3.S2 (SHIELD), J3.S3 (SHIELD), J3.S4 (SHIELD), R67.2, R68.2, R73.2, U23.2 (GND), U24.2 (GND)
unnamed: C71.2, D13.1 (K), Q14.2 (S), U24.1 (IN), U24.3 (EN)
unnamed: D7.1 (A1), F1.2, FB5.1
unnamed: D11.1 (K), Q14.3 (D)
unnamed: F1.1, J3.A9 (VBUS), J3.B9 (VBUS)
unnamed: J3.A5 (CC1), R67.1
unnamed: J3.B5 (CC2), R68.1

Notes on the sheet:
NEED FOOTPRINT CAP and FUSE
