bitbangbill/photoelectric-effect-demonstrator/(commit log)

2026-03-18 reworked the digital isolation block
    [digital_isolation.kicad_sch, photoelectric_effect_demonstrator.kicad_sch, phototube_instrumentation.kicad_sch, tia_feedback_select.kicad_sch]
2026-03-19 rework to tia feedback selection, board power, and ui
    [adc.kicad_sch, button_pullup.kicad_sch, digital_isolation.kicad_sch, dual_rail_variable_psu.kicad_sch, encoder_layout.kicad_sch, fanout.kicad_sch, microcontroller.kicad_sch, phototube_instrumentation.kicad_sch]
2026-09-15 chore: many changes checkpoint
    [CCG6-12-15DR.step, TLV75533PDBVR.STEP, USB4110-GF-A.STEP, USB4135-GF-A.step, adc.kicad_sch, button_pullup.kicad_sch, digital_isolation.kicad_sch, dual_rail_variable_psu.kicad_sch]
